1M-Ventilators/papr-electrical/batt-ti/battery-board-annotated.png

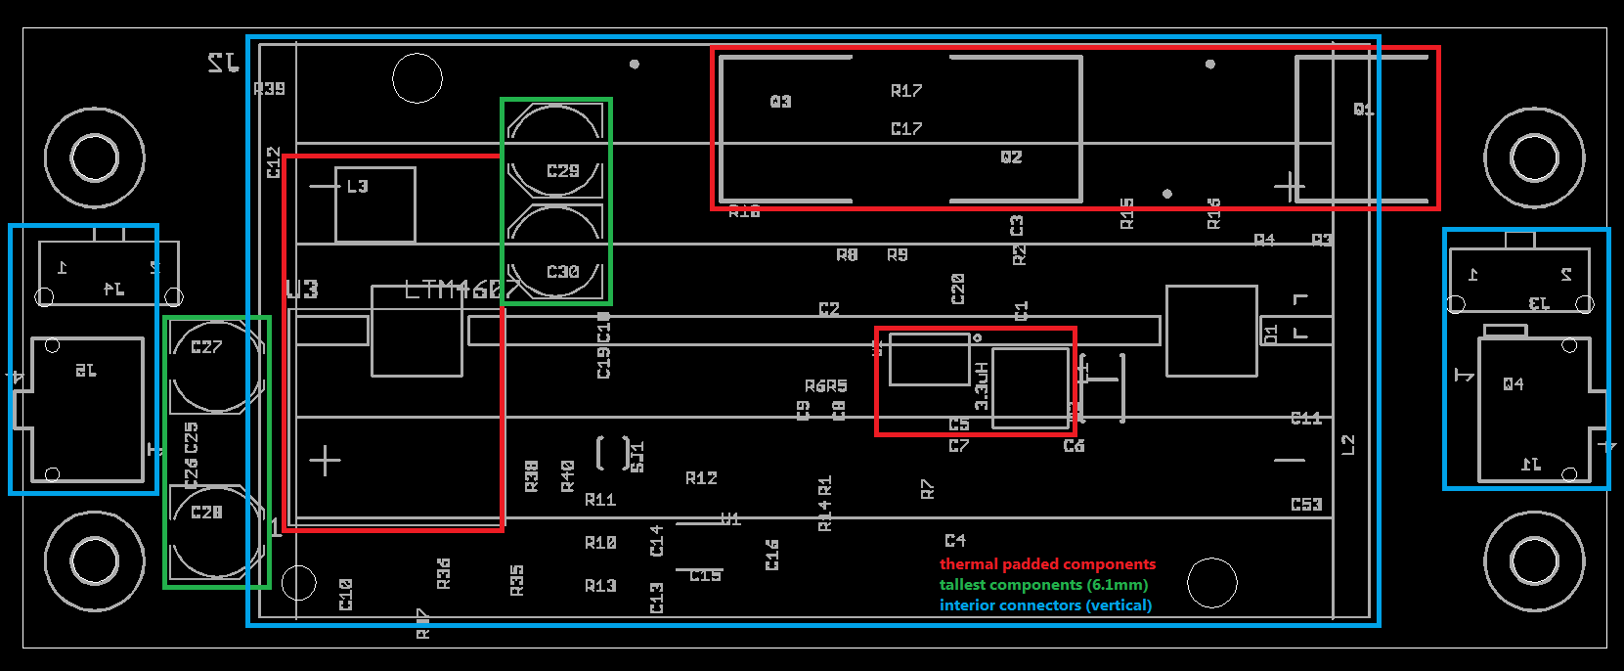
batt-ti/battery-board-annotated.png
