1M-Ventilators/papr-electrical/batt-ti/pm-batt-ti_bom.xlsx

Item # | Qty | Part | Package | Tech. | Description | Vendor | Vendor P/N | Manufacturer | Manufacturer P/N:
1 | 5 | C1; C8-C9; C19-C20 | 1206 | SMT | 10u, Ceramic, 10%, 50V, X5R | Digikey | 445-5998-1-ND | TDK Corporation | C3216X5R1H106K160AB
2 | 4 | C2-C4; C17 | 603 | SMT | 1u, Ceramic, 10%, 50V, X5R | Digikey | 445-7468-1-ND | TDK Corporation | C1608X5R1H105K080AB
3 | 1 | C5 | 603 | SMT | 47n, Ceramic, 10%, 50V, X5R | Digikey | 445-14155-1-ND | TDK Corporation | C1608X5R1H473K080AA
4 | 10 | C6-C7; C10-C16; C18 | 603 | SMT | 0.1u, Ceramic, 10%, 50V, X5R | Digikey | 445-7456-1-ND | TDK Corporation | C1608X5R1H104K080AA
5 | 4 | C21-C24 | 2917 | SMT | 150u, Tantalum, 10%, 16V | Digikey | 718-1494-1-ND | Vishay Sprague | TR3D157K016C0100
6 | 2 | C25-C26 | 1206 | SMT | 22u, Ceramic, 20%, 35V, X5R | Digikey | 445-8045-1-ND | TDK Corporation | C3216X5R1V226M160AC
7 | 1 | C27 | 603 | SMT | 2.2n, Ceramic, 10%, 50V, C0G | Digikey | 445-13978-1-ND | TDK Corporation | C1608C0G1H222K080AA
8 | 1 | D1 | SOT-23 | SMT | Dual Schottky Common Cathode | Digikey | BAT54CFSCT-ND | Fairchild Semi | BAT54C
9 | 1 | D2 | SMA | SMT | Power Schottky, 0.45V/40V, 3A | Digikey | B340LA-FDICT-ND | Diodes Inc | B340LA-13-F
10 | 2 | J1; J5 | 2 x 2 - 3mm | PTH | Microfit 4-pin - Power In & Out | Digikey | WM1796-ND | Molex Inc | 43045-0414
11 | 1 | J2 | 2 x 18650 | SMT | 2-cell 18650 Battery Holder | Digikey | 36-1048-ND | Keystone | 1048
12 | 2 | J3; J4 | 2 x 1 - 3mm | PTH | Microfit 2-pin - Temp & Vsense | Digikey | WM1922-ND | Molex Inc | 43650-0216
13 | 1 | L1 | NONSTD | SMT | 3.3uH, 5A/54.7m, Shielded, 20% | Digikey | 541-1269-1-ND | Vishay Dale | IHLP2020CZER3R3M01
14 | 1 | L2 | 1206 | SMT | Ferrite Chip, 6A, 0.018 ohm | Digikey | 240-2411-1-ND | Laird | HI1206T161R-10
15 | 1 | L3 | NONSTD | SMT | 2.2uH, 5.8A/29.2m, Shielded, 20% | Digikey | 541-1268-1-ND | Vishay Dale | IHLP2020CZER2R2M01
16 | 2 | Q1-Q2 | D2-PAK | SMT | N-Channel PowerTrench MOSFET | Digikey | FDB047N10CT-ND | Fairchild Semi | FDB047N10
17 | 1 | Q3 | D2-PAK | SMT | PMOS, 60V, 110A, 3.75W | Digikey | SUM110P06-07L-E3CT-ND | Vishay Siliconix | SUM110P06-07L-E3
18 | 1 | Q4 | SOT-23 | SMT | NMOS, 30V, 0.3A, 0.35W | Digikey | 2N7002KCT-ND | Fairchild Semi | 2N7002K
19 | 2 | R1; R4 | 603 | SMT | 100k, Thick Film, 1%, 1/4 W | Digikey | P100KBYCT-ND | Panasonic | ERJ-PA3F1003V
20 | 2 | R2; R23 | 603 | SMT | 2r, Thick Film, 5%, 1/4 W | Digikey | P2.00BZCT-ND | Panasonic | ERJ-PA3J2R0V
21 | 1 | R3 | 603 | SMT | 1M, Thick Film, 1%, 1/4 W | Digikey | P1.0MBYCT-ND | Panasonic | ERJ-PA3F1004V
22 | 1 | R5 | 603 | SMT | 309k, Thin Film, 0.1%, 1/6 W | Digikey | A110347CT-ND | TE Connectivity | 3-2176090-7
23 | 4 | R6; R9; R14; R20 | 603 | SMT | 43k, Thick Film, 1%, 1/4 W | Digikey | P43KBYCT-ND | Panasonic | ERJ-PA3F4302V
24 | 2 | R7; R17 | 805 | SMT | 10m, Thick Film, 1%, 1/2 W | Digikey | P.01AQCT-ND | Panasonic | ERJ-6BWFR010V
25 | 1 | R8 | 603 | SMT | 7.5k, Thick Film, 1%, 1/4 W | Digikey | P7.5KBYCT-ND | Panasonic | ERJ-PA3F7501V
26 | 3 | R10-R11; R18 | 603 | SMT | 1k, Thick Film, 1%, 1/4 W | Digikey | P1.0KBYCT-ND | Panasonic | ERJ-PA3F1001V
27 | 2 | R12-R13 | 603 | SMT | 120r, Thick Film, 1%, 1/4 W | Digikey | P120BYCT-ND | Panasonic | ERJ-PA3F1200V
28 | 2 | R15-R16 | 603 | SMT | 4.02k, Thin Film, 0.1%, 1/6 W | Digikey | A110166CT-ND | TE Connectivity | 6-2176088-4
29 | 1 | R19 | 603 | SMT | 28.7k, Thin Film, 0.1%, 1/6 W | Digikey | A110248CT-ND | TE Connectivity | 4-2176089-0
30 | 1 | R21 | 603 | SMT | 7.15k, Thin Film, 0.1%, 1/6 W | Digikey | A110190CT-ND | TE Connectivity | 8-2176088-7
31 | 2 | R22; R24 | 805 | SMT | 15m, Thick Film, 1%, 1/2 W | Digikey | P.015AQCT-ND | Panasonic | ERJ-6BWFR015V
32 | 1 | U1 | SON-8-EP | SMT | BQ29209 Battery OVP & Balancer | Digikey | 296-27677-1-ND | Texas Instruments | BQ29209DRBR
33 | 1 | U2 | QFN-24-TP | SMT | BQ24170 Battery Charger / Manager | Digikey | 296-28049-1-ND | Texas Instruments | BQ24170RGYT
34 | 1 | U3 | LGA-141 | SMT | LTM4607 12V Boost IC | Digikey | LTM4607EV#PBF-ND | Linear | LTM4607EV#PBF
