1M-Ventilators/papr-electrical/batt-ti/pm-batt-ti.dxf

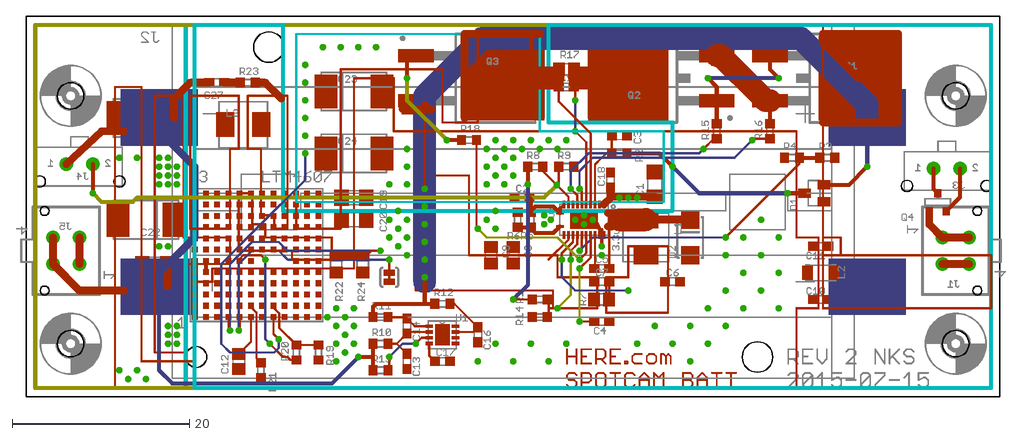
[picture p2: CAD file, 2020-04-03]
batt-ti/pm-batt-ti.dxf
111.8 x 43.0
