1M-Ventilators/papr-electrical/batt-ti/pm-batt-ti.brd

## EAGLE design batt-ti/pm-batt-ti.brd (2020-04-03)

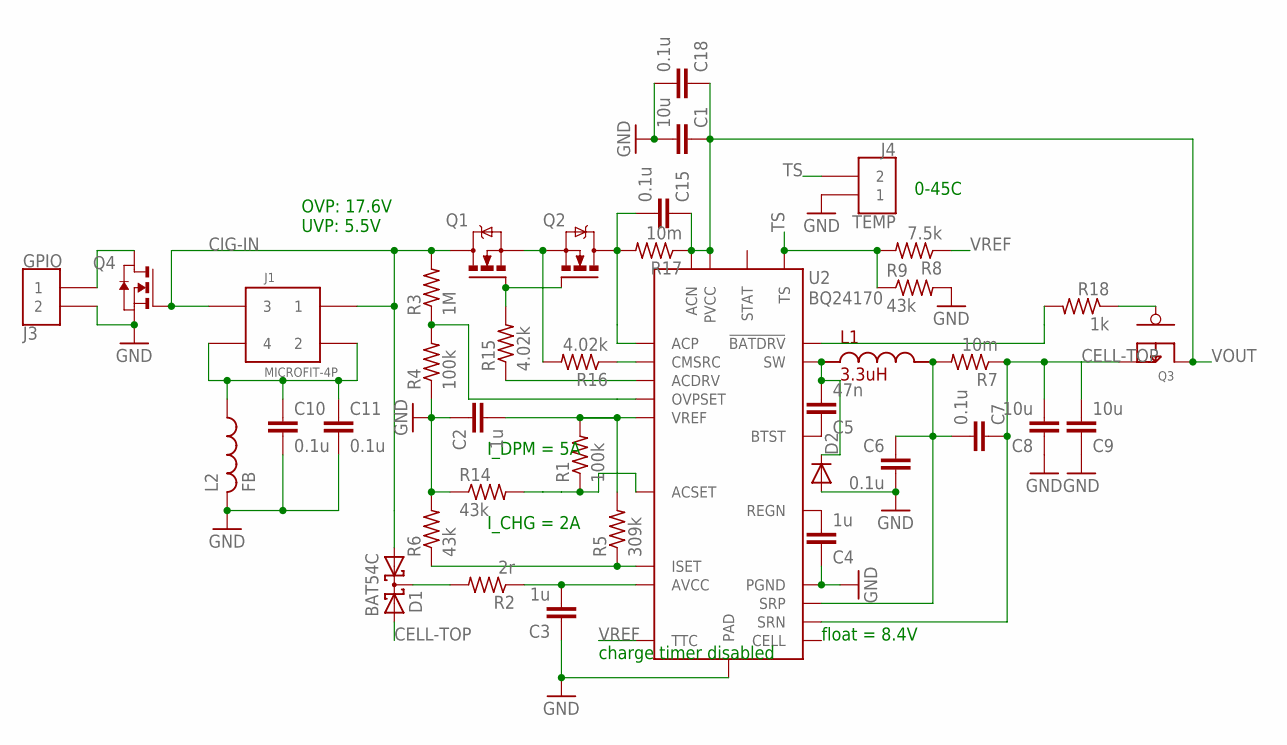
[picture p3: schematic pm-batt-ti.sch, sheet 1]

Parts:
C1: 10u; C1206
C2, C3, C4: 1u; C0603
C5: 47n; C0603
C6, C7, C10, C11, C15, C18: 0.1u; C0603
C8, C9: 10u; C0805
D1: BAT54C; SOT23
D2: DIODESMA-ALT; SMA-DIODE_ALT
J1: MICROFIT-4P
J3: GPIO; MICROFIT-2P
J4: TEMP; MICROFIT-2P
L1: 3.3uH; L-VISHAY-IHLP2020CZ01
L2: FB; L3216C
Q1, Q2: FDB047N10; D2_PAK
Q3: SUM110P; D2_PAK
Q4: NMOSSOT23; SOT-23
R1, R4: 100k; R0603
R2: 2r; R0603
R3: 1M; R0603
R5: 309k; R0603
R6, R9, R14: 43k; R0603
R7, R17: 10m; R0805
R8: 7.5k; R0603
R15, R16: 4.02k; R0603
R18: 1k; R0603
U2: BQ24170; QFN-24-TP

Connections:
CELL-TOP: C7.1, C8.2, C9.2, D1.2 (A2), Q3.3 (S3), R7.1, U2.15 (SRN); also elsewhere on the board
CIG-IN: D1.1 (A1), J1.1, J1.3, Q1.4 (D), Q4.3 (G), R3.2
GND: C1.2, C2.1, C3.1, C4.1, C6.2, C8.1, C9.1, C10.2, C11.2, C18.2, D2.A, J3.P$2 (2), J4.P$1 (1), L2.2, Q4.2 (S), R4.1, R6.2, R9.2, R14.1, U2.22 (PGND), U2.23 (PGND), U2.TP (PAD); also elsewhere on the board
unnamed: C15.2, Q2.4 (D), R17.2, U2.6 (ACP)
unnamed: R3.1, R4.2, U2.18 (OVPSET)
unnamed: R1.1, R14.2, U2.17 (ACSET)
unnamed: C3.2, R2.1, U2.4 (AVCC)
unnamed: R5.1, R6.1, U2.13 (ISET)
unnamed: C4.2, U2.20 (REGN)
unnamed: C5.2, D2.C, L1.P$1, U2.1 (SW), U2.24 (SW)
unnamed: C5.1, U2.21 (BTST)
unnamed: C6.1, C7.2, L1.P$2, R7.2, U2.16 (SRP)
unnamed: D1.3 (CC), R2.2
unnamed: R18.2, U2.19 (!BATDRV)
unnamed: Q1.3 (S), Q2.3 (S), R16.2
unnamed: Q3.1 (G4), R18.1
unnamed: Q1.1 (G), Q2.1 (G), R15.2
unnamed: R15.1, U2.8 (ACDRV)
unnamed: R16.1, U2.7 (CMSRC)
unnamed: J3.P$1 (1), Q4.1 (D)
SHLD: C10.1, C11.1, J1.2, J1.4, L2.1
TS: J4.P$2 (2), R8.2, R9.1, U2.10 (TS)
VOUT: C1.1, C15.1, C18.1, Q3.4 (D8), R17.1, U2.2 (PVCC), U2.3 (PVCC), U2.5 (ACN); also elsewhere on the board
VREF: C2.2, R1.2, R5.2, R8.1, U2.11 (TTC), U2.12 (VREF)

Notes on the sheet:
I_DPM = 5A
float = 8.4V
charge timer disabled
OVP: 17.6V UVP: 5.5V
I_CHG = 2A
0-45C

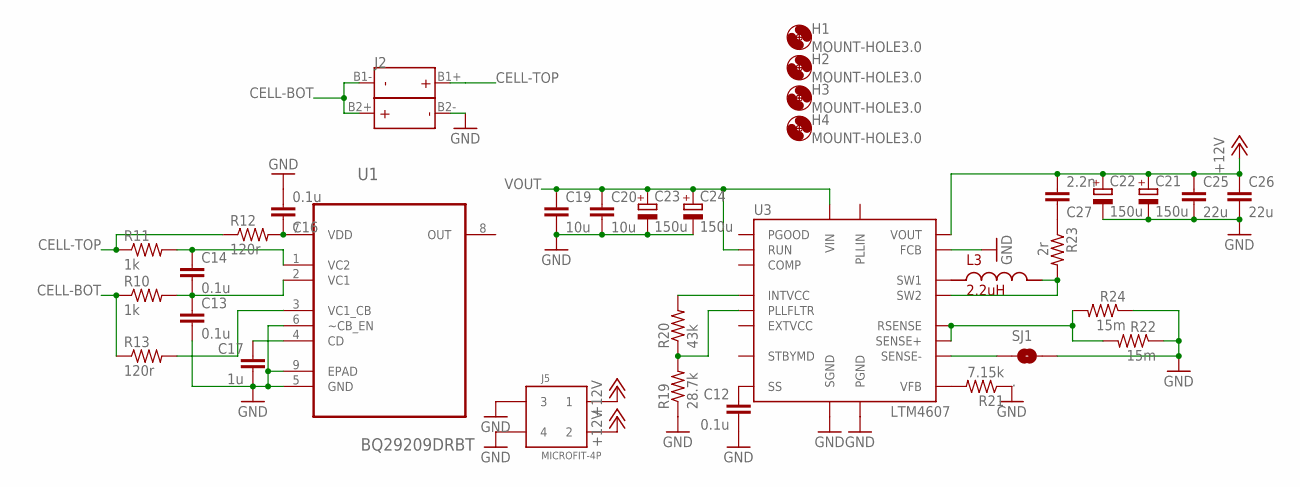
[picture p4: schematic pm-batt-ti.sch, sheet 2]

Parts:
C12: 0.1u; C0805
C13, C14, C16: 0.1u; C0603
C17: 1u; C0603
C19, C20: 10u; C1206
C21, C22, C23, C24: 150u; C2917
C25, C26: 22u; C1206
C27: 2.2n; C0603
H1, H2, H3, H4: MOUNT-HOLE3.0; 3,0
J2: 18650X2; K1048
J5: MICROFIT-4P
L3: 2.2uH; L-VISHAY-IHLP2020CZ01
R10, R11: 1k; R0603
R12, R13: 120r; R0603
R19: 28.7k; R0603
R20: 43k; R0603
R21: 7.15k; R0603
R22, R24: 15m; R0805@1
R23: 2r; R0603
SJ1: .; SJ_2S-TRACE
U1: BQ29209DRBT; SON65P315X315X100-9N
U3: LTM4607

Connections:
+12V: C21.+, C22.+, C25.1, C26.1, C27.2, J5.1, J5.2, U3.E1 (VOUT), U3.E2 (VOUT), U3.F1 (VOUT), U3.F2 (VOUT), U3.F3 (VOUT), U3.F4 (VOUT), U3.G1 (VOUT), U3.G2 (VOUT), U3.G3 (VOUT), U3.G4 (VOUT), U3.H1 (VOUT), U3.H2 (VOUT), U3.H3 (VOUT), U3.H4 (VOUT)
CELL-BOT: J2.B1-, J2.B2+, R10.1, R13.1
CELL-TOP: J2.B1+, R11.1, R12.1; also elsewhere on the board
GND: C12.2, C13.2, C16.2, C17.2, C19.2, C20.2, C21.-, C22.-, C23.-, C24.-, C25.2, C26.2, J2.B2-, J5.3, J5.4, R19.1, R21.1, R22.1, R24.1, SJ1.2, U1.5 (GND), U1.6 (~CB_EN), U1.9 (EPAD), U3.A1 (PGND), U3.A2 (PGND), U3.A3 (PGND), U3.A7 (SGND), U3.A9 (FCB), U3.A11 (PGND), U3.A12 (PGND), U3.B1 (PGND), U3.B2 (PGND), U3.B3 (PGND), U3.B4 (PGND), U3.B10 (PGND), U3.B11 (PGND), U3.B12 (PGND), U3.C1 (PGND), U3.C2 (PGND), U3.C3 (PGND), U3.C4 (PGND), U3.C5 (PGND), U3.C6 (PGND), U3.C7 (PGND), U3.C8 (PGND), U3.C9 (PGND), U3.C10 (PGND), U3.C11 (PGND), U3.C12 (PGND), U3.D1 (PGND), U3.D2 (PGND), U3.D3 (PGND), U3.D4 (PGND), U3.D5 (PGND), U3.D6 (PGND), U3.D7 (PGND), U3.D8 (PGND), U3.D9 (PGND), U3.D10 (PGND), U3.D11 (PGND), U3.D12 (PGND), U3.E3 (PGND), U3.E4 (PGND), U3.E5 (PGND), U3.E6 (PGND), U3.E7 (PGND), U3.E8 (PGND), U3.E9 (PGND), U3.E10 (PGND), U3.E11 (PGND), U3.E12 (PGND); also elsewhere on the board
unnamed: C17.1, U1.4 (CD)
unnamed: R19.2, R20.1, U3.B8 (PLLFLTR)
unnamed: L3.P$1, U3.J1 (SW1), U3.J2 (SW1), U3.J3 (SW1), U3.J4 (SW1), U3.K1 (SW1), U3.K2 (SW1), U3.K3 (SW1), U3.K4 (SW1), U3.L1 (SW1), U3.L2 (SW1), U3.L3 (SW1), U3.L4 (SW1), U3.M1 (SW1), U3.M2 (SW1), U3.M3 (SW1), U3.M4 (SW1)
unnamed: C13.1, C14.2, R10.2, U1.2 (VC1)
unnamed: C14.1, R11.2, U1.1 (VC2)
unnamed: R20.2, U3.F5 (INTVCC)
unnamed: C16.1, R12.2, U1.7 (VDD)
unnamed: R13.2, U1.3 (VC1_CB)
unnamed: C12.1, U3.A6 (SS)
unnamed: R21.2, U3.B6 (VFB)
unnamed: C27.1, R23.1
unnamed: SJ1.1, U3.A5 (SENSE-)
RSENSE: R22.2, R24.2, U3.A4 (SENSE+), U3.F10 (RSENSE), U3.F11 (RSENSE), U3.F12 (RSENSE), U3.G5 (RSENSE), U3.G6 (RSENSE), U3.G7 (RSENSE), U3.G8 (RSENSE), U3.G9 (RSENSE), U3.G10 (RSENSE), U3.G11 (RSENSE), U3.G12 (RSENSE), U3.H5 (RSENSE), U3.H6 (RSENSE), U3.H7 (RSENSE), U3.H8 (RSENSE), U3.H9 (RSENSE), U3.H10 (RSENSE), U3.H11 (RSENSE), U3.H12 (RSENSE), U3.J5 (RSENSE), U3.J6 (RSENSE), U3.J7 (RSENSE), U3.K5 (RSENSE), U3.K6 (RSENSE), U3.L5 (RSENSE), U3.L6 (RSENSE), U3.M5 (RSENSE), U3.M6 (RSENSE)
SW2: L3.P$2, R23.2, U3.J8 (SW2), U3.J9 (SW2), U3.K7 (SW2), U3.K8 (SW2), U3.K9 (SW2), U3.L7 (SW2), U3.L8 (SW2), U3.L9 (SW2), U3.M7 (SW2), U3.M8 (SW2), U3.M9 (SW2)
VOUT: C19.1, C20.1, C23.+, C24.+, U3.A8 (RUN), U3.J10 (VIN), U3.J11 (VIN), U3.J12 (VIN), U3.K10 (VIN), U3.K11 (VIN), U3.K12 (VIN), U3.L10 (VIN), U3.L11 (VIN), U3.L12 (VIN), U3.M10 (VIN), U3.M11 (VIN), U3.M12 (VIN); also elsewhere on the board

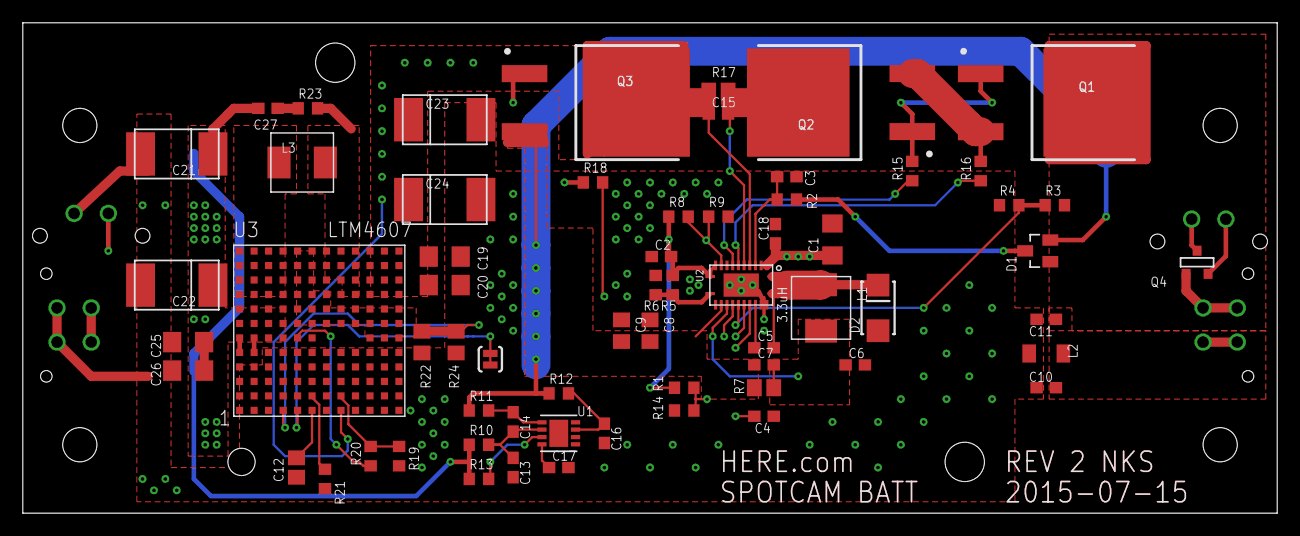
[picture p5: board pm-batt-ti.brd from above]

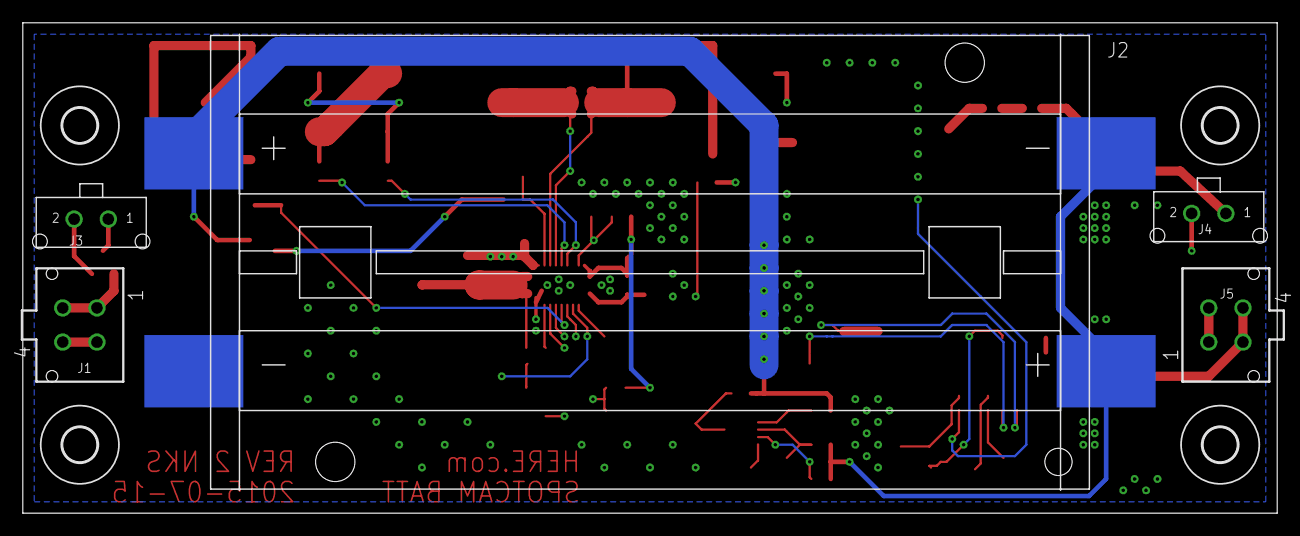
[picture p6: board pm-batt-ti.brd from below]

Board: 4 copper layers, 110.0 x 43.0 mm, 73 parts (9 on the bottom side), 40 nets.
