1M-Ventilators/papr-electrical/(threads)

Thread 2 (2020-04-03):

Go / no-go on daughter buzzer pcb

neelfirst, 2020-04-03:
BUZZER: we're going to need a hole for air to travel for the buzzer to signal.  I know the spec rn says a "sealed" buzzer, but if it's sealed you won't be able to hear it.  I'm thinking of having a daughter board for the buzzer for now, so we can position it where we like.  How does this sound?

ceiber-uom, 2020-04-08:
The conclusion was to mount the PCB behind the filter so the buzzer is in the same cavity as the air between the filter and the fan.

This issue was discussed and resolved in https://docs.google.com/document/d/1QxQEv6MbkUzINU17CkgeMOkP1r9ut0EzaXadpK1-evY/edit

Thread 3 (2020-04-03):

spike: Investigate clip-on batteries

neelfirst, 2020-04-03:
BATT: we need somebody to investigate battery terminal for clip on batts.  This is a research project, but shouldn't take more than a couple hours tops.  For now, I'm just going to use standard JST-XH 2.54mm connectors (which will go to a battery clip connector daughter board)

Thread 4 (2020-04-03):

Standoff size

neelfirst, 2020-04-03:
SCREWS / STANDOFFS: any strong opinions here?  Personally I'm a fan of 3mm machines phillips screws, so I can make holes to accommodate that.

PCB_EEToday at 4:15 AM
These are great!  I think we should stick with common values, M2, M3, etc
Calvin E.Today at 4:16 AM
OK, I'll increase the drill size and let's use M2

Thread 5 (2020-04-03):

Determine need for papr-hood leds

neelfirst, 2020-04-03:
HOOD LEDS: did we ever reach a consensus for having the LEDs in the mask?  Buzzer too?  If we decide to go this route, we'll have to make a plug for a wire harness to travel up to the hood and a separate daughter board.

@axiverse: I think hood led can be saved for later. Just buttons is okay. I’ll get back to you on UI tomorrow. Wake power button is okay.

Thread 6 (2020-04-03):

finalize UI part selection

neelfirst, 2020-04-03:
SWITCHES / KNOBS: I strongly recommend that we use standard DTS-6 6mm tactile push buttons.  Have we made a decision as to whether or not we want to use a knob? It seems like the general consensus is leaning towards  + and - buttons instead.  I can definitely go along with that, since it will obviously be more sealable.  How many buttons should I incorporate into the design at this point? So far I'm thinking 3: Power / modes and + and - buttons

Thread 8 (2020-04-05):

COTS battery management circuit

neelfirst, 2020-04-05:
2S/10A Available for purchase at Walmart

https://www.walmart.com/ip/Genuine-SP-2S-10A-7-4V-18650-Lithium-Battery-Protection-Board-8-4V-Balanced-Function-Overcharged-Protection/487215666

Circuit analysis is here:

https://github.com/1M-Ventilators/HX-2S-JH20-JH10-reverse-engineered_aka-2S-10A-Balance-Li-ion-Protection-PCB

The fallback is to design this ourselves in the event suppliers are out of stock of the PCBs.

neelfirst, 2020-04-05:
Other notes on BMS (probably deprecated in favor of above)

https://easyeda.com/anex5/bms-module
BMS Module -
    EasyEDA
BMS module for 3 serial Li-Ion 18650 Battery pack.
https://easyeda.com/ELied/bms-circuit
HX-2S-JH20 V1.0 - Chinese BMS Circuit -
    EasyEDA
Replicating the circuit of HX-2S-JH20 BMS for education purpose. This PCB or schematic will have error and flaws and has not been tested. Edit, Use and recreate it at your own risks.

Thread 9 (2020-04-05):

UI definition

neelfirst, 2020-04-05:
Requirements

'84.312 Low Pressure indicator; minimum requirements
(a) For positive pressure PAPR, a low pressure indicator must actively and readily indicate
when pressure inside the respiratory inlet covering falls to ambient pressure
(b) Low pressure indicators must be readily visible or detectable (via sound or vibration) to the
user without manipulation of the respirator
'84.313 Low flow indicators; minimum requirements
(a) For non-positive pressure PAPR, a low flow indicator must actively and readily indicate if
the airflow inside the respiratory inlet covering drops to the minimum specified flow rate in this subpart.
 (b) Low flow indicators must be readily visible or detectable (via sound or vibration) to the user
without manipulation of the respirator
'84.314 Full and low battery power indicator, minimum requirements
(a) Each PAPR equipped with a battery must contain an indicator to show when the battery is
fully charged
(b) Each PAPR equipped with a battery must contain a low battery indicator and must indicate
when or before when the battery can no longer provide the unit with 15 minutes of additional adequate
power to properly power the unit at the lowest recommended operating temperature and at the highest
flow demand with the highest resistance combination of cartridges/canisters/filters
(c) Low battery indicators must be readily visible or detectable (via sound or vibration) to the
user without manipulation of the respirator

neelfirst, 2020-04-05:
Solution:

green = power / bat good
red = low batt
blue1 = fan 1 status
blue2 = fan 2 status
amber = pressure status

OFF = x
POWERUP = blink green
ON = battery status, see FULL BATT, LOW BATT, VERY LOW BATT

FULL BATT (90%+) = solid green
dim between green/red in between
LOW BATT (-20%) = solid red
VERY LOW BATT (-5%) = blink red

NORMAL PRESSURE = slow blink amber
LOW PRESSURE = fast blink amber
SENSOR ERROR = solid amber

FANn NORMAL = slow blink blue_n
FANn ABNORMAL = fast blink blue_n
FANn ERROR = solid blue_n
